tankaicong/Hornet-X-Acoustics/hardware/Acoustics_filter_v2/Project Outputs for Acoustics_filter_v2/Acoustics_filter_v2_BOM.xlsx

Name | Description | Designator | Quantity | Footprint
GCM1885C2A361FA16D | Ceramic Capacitor, Multilayer, Ceramic, 100V, 1% +Tol, 1% -Tol, C0G, 30ppm/Cel TC, 0.00036uF, Surface Mount, 0603 | C1, C3, C4, C6 | 4 | FP-GCM188-0_1-IPC_B
GRM1885C1H331FA01D | Ceramic Capacitor, Multilayer, Ceramic, 50V, 1% +Tol, 1% -Tol, C0G, -/+30ppm/Cel TC, 0.00033uF, Surface Mount, 0603 | C2, C5 | 2 | FP-GCM188-0_1-IPC_B
GRM188R61E106KA73D | 25V 10uF Ceramic Capacitor, Multilayer, Ceramic, 25V, 10% +Tol, 10% -Tol, X5R, 15% TC, 10uF, Surface Mount, 0603 | C7, C9 | 2 | FP-GCM188-0_1-IPC_B
CC0603KRX7R9BB104 | 50V 100nF Ceramic Capacitor, Multilayer, Ceramic, 50V, 10% +Tol, 10% -Tol, X7R, 15% TC, 0.1uF, Surface Mount, 0603 | C8, C10, C11 | 3 | FP-GCM188-0_1-IPC_B
61300611121 | 6P Single Row 2.54mm Wurth Elektronik Header Pin (inverted 3D model) | J1 | 1 | 61300611121-Footprint-1
RC0603FR-0710KL | 10k 1% Fixed Resistor, Metal Glaze/thick Film, 0.1W, 10000ohm, 75V, 1% +/-Tol, 100ppm/Cel, Surface Mount, 0603 | R1, R8 | 2 | FP-RT0603-IPC_B
RT0603BRD07165KL | 165k Fixed Resistor, Thin Film, 0.1W, 165000ohm, 75V, 0.1% +/-Tol, 25ppm/Cel, Surface Mount, 0603 | R2 | 1 | FP-RT0603-IPC_B
RT0603BRD07102KL | 102k Fixed Resistor, Thin Film, 0.1W, 102000ohm, 75V, 0.1% +/-Tol, 25ppm/Cel, Surface Mount, 0603 | R3, R4 | 2 | FP-RT0603-IPC_B
RT0603BRD0782K5L | 82.5k Fixed Resistor, Thin Film, 0.1W, 82500ohm, 75V, 0.1% +/-Tol, 25ppm/Cel, Surface Mount, 0603 | R5 | 1 | FP-RT0603-IPC_B
RT0603BRD0780K6L | 80.6k Fixed Resistor, Thin Film, 0.1W, 80600ohm, 75V, 0.1% +/-Tol, 25ppm/Cel, Surface Mount, 0603 | R6, R7 | 2 | FP-RT0603-IPC_B
RT0603BRD07576RL | 576R Fixed Resistor, Thin Film, 0.1W, 576ohm, 75V, 0.1% +/-Tol, 25ppm/Cel, Surface Mount, 0603 | R9 | 1 | FP-RT0603-IPC_B
RT0603BRD071K05L | 1.05k Fixed Resistor, Thin Film, 0.1W, 1050ohm, 75V, 0.1% +/-Tol, 25ppm/Cel, Surface Mount, 0603 | R10, R12 | 2 | FP-RT0603-IPC_B
RT0603BRD0714K3L | 14.3k Fixed Resistor, Thin Film, 0.1W, 14300ohm, 75V, 0.1% +/-Tol, 25ppm/Cel, Surface Mount, 0603 | R11 | 1 | FP-RT0603-IPC_B
RT0603BRD0714K7L | 14.7k Fixed Resistor, Thin Film, 0.1W, 14700ohm, 75V, 0.1% +/-Tol, 25ppm/Cel, Surface Mount, 0603 | R13 | 1 | FP-RT0603-IPC_B
RC0603FR-074K99L | 4.99k 1% Fixed Resistor, Metal Glaze/thick Film, 0.1W, 4990ohm, 75V, 1% +/-Tol, 100ppm/Cel, Surface Mount, 0603 | R14 | 1 | FP-RT0603-IPC_B
RT0603BRD07154RL | 154R Fixed Resistor, Thin Film, 0.1W, 154ohm, 75V, 0.1% +/-Tol, 25ppm/Cel, Surface Mount, 0603 | R15 | 1 | FP-RT0603-IPC_B
RT0603BRD07158RL | 158R Fixed Resistor, Thin Film, 0.1W, 158ohm, 75V, 0.1% +/-Tol, 25ppm/Cel, Surface Mount, 0603 | R16 | 1 | FP-RT0603-IPC_B
TL974IDR | Operational Amplifier, 4 Func, 6000uV Offset-Max, BIPolar, PDSO14 | U1 | 1 | D0014A_N
