tankaicong/Hornet-X-Acoustics/hardware/Acoustics_motherboard/Project Outputs/Acoustics_motherboard_BOM.xlsx

Line # | Name | Description | Designator | Quantity | Footprint
 | CC0603KRX7R9BB104 | 50V 100nF Ceramic Capacitor, Multilayer, Ceramic, 50V, 10% +Tol, 10% -Tol, X7R, 15% TC, 0.1uF, Surface Mount, 0603 | C1, C4, C8, C10, C13, C15 | 6 | FP-GCM188-0_1-IPC_A
 | GRM188R61E106KA73D | 25V 10uF Ceramic Capacitor, Multilayer, Ceramic, 25V, 10% +Tol, 10% -Tol, X5R, 15% TC, 10uF, Surface Mount, 0603 | C2 | 1 | FP-GCM188-0_1-IPC_A
 | CC0805KKX7R9BB334 | Ceramic Capacitor, Multilayer, Ceramic, 50V, 10% +Tol, 10% -Tol, X7R, 15% TC, 0.33uF, Surface Mount, 0805 | C3 | 1 | FP-CC0805-0_85-IPC_A
 | CC0805KKX7R9BB105 | Ceramic Capacitor, Multilayer, Ceramic, 50V, 10% +Tol, 10% -Tol, X7R, 15% TC, 1uF, Surface Mount, 0805 | C7, C9, C12, C14 | 4 | FP-CC0805-0_85-IPC_A
 | CGA3E2X7R1H103KT0Y0N | 50V 10nF ceramic 0603 capacitor | C16 | 1 | FP-GCM188-0_1-IPC_A
 | C2012X5R1V226MT000E | 35V 22uF X5R 卤20% 0805 Multilayer Ceramic Capacitors MLCC - SMD/SMT ROHS | C17, C18 | 2 | FP-CC0805-0_85-IPC_A
 | 16TQC150MYF | Tantalum Capacitor, Polarized, Tantalum (solid Polymer), 16V, 20% +Tol, 20% -Tol, 150uF, Surface Mount, 2917 | C19 | 1 | FP-POSCAP-D3L-MFG
 | SS34_C8678 | SS34 40V 3A Schottky Diode | D2 | 1 | SS34_C8678-Footprint-1
 | 61300311121 | Board Connector, 3 Contact(s), 1 Row(s), Male, Straight, 0.1 inch Pitch, Solder Terminal, Locking, Black Insulator, Plug (inverted 3D model) | J1 | 1 | 61300311121
 | 61300411121 | 4P Single Row 2.54mm Wurth Elektronik Header Pin (inverted 3D model) | J2 | 1 | 61300411121-Footprint-1
 | 61300611821 | 6P Single Row 2.54mm Wurth Elektronik Female Header Pin | J3, J4, J5, J6 | 4 | 61300611821
 | B4B-XH-A(LF)(SN) | Header for PCB; pitch 2.50mm; 4-contacts; THT male; top entry; 250V/3A | J7, J8, J11, J12 | 4 | FP-B4B-XH-A_LF_SN-MFG
 | NO jumper | Normally-Open SMD jumper pads | J9, J10, J13, J14 | 4 | JUMPER
 | FXL0630-220-M | 2.5A 22uH Integrated molded inductor ±20% 3A SMD,6.6x7mm Power Inductors ROHS | L2 | 1 | INDP7066X28N
 | RC0603FR-0710KL | 10k 1% Fixed Resistor, Metal Glaze/thick Film, 0.1W, 10000ohm, 75V, 1% +/-Tol, 100ppm/Cel, Surface Mount, 0603 | R1, R4 | 2 | FP-RT0603-IPC_A
 | RC0603FR-072K32L | 2.32k 1% Fixed Resistor, Metal Glaze/thick Film, 0.1W, 2320ohm, 75V, 1% +/-Tol, 100ppm/Cel, Surface Mount, 0603 | R5 | 1 | FP-RT0603-IPC_A
 | B3U-1000P | Switch Tactile N.O. SPST Round Button Solder Tab 12VDC 200000Cycles 1.5N SMD Emboss T/R | SW1 | 1 | FP-B3U-1000P-MFG
 | DEV-16771 | RT1062 Teensy 4.1 series ARM® Cortex®-M7 MPU Embedded Evaluation Board | U1 | 1 | DEV-16771-Footprint-1
 | SN65HVD230DR | Interface Circuit, 1-Trnsvr, BICMOS, PDSO8 | U2 | 1 | FP-D0008A-IPC_B
 | 78L12G-AB3-R | 12V 100mA LDO Regulator | U3 | 1 | 78L12G-AB3-R-Footprint-1
 | AMS1117-5.0 | 5V Reg | U4 | 1 | AMS1117-5.0-Footprint-1
 | AMS1117-3.3 | 3.3V Reg | U6 | 1 | AMS1117-5.0-Footprint-1
 | TPS5430DDA | Switching Regulator, Voltage-mode, 6A, 500kHz Switching Freq-Max, PDSO8 | U7 | 1 | FP-DDA0008J-MFG
