tankaicong/Hornet-X-Acoustics/(list of files, drawings)

Other design files:
hardware/Acoustics_filter_v2/Acoustics_filter_v2.PrjPcb
hardware/Acoustics_filter_v2/Filter.SchDoc
hardware/Acoustics_filter_v2/Filter_v2.PcbDoc
hardware/Acoustics_motherboard/Acoustics_motherboard.PrjPcb
hardware/Acoustics_motherboard/Filters.SchDoc
hardware/Acoustics_motherboard/Power.SchDoc
hardware/Acoustics_motherboard/Teensy_and_ICs.SchDoc
